irfannazril/esp8266-transceiver-robot-soccer/flowchart/Flowchart-program-receiver -white.png

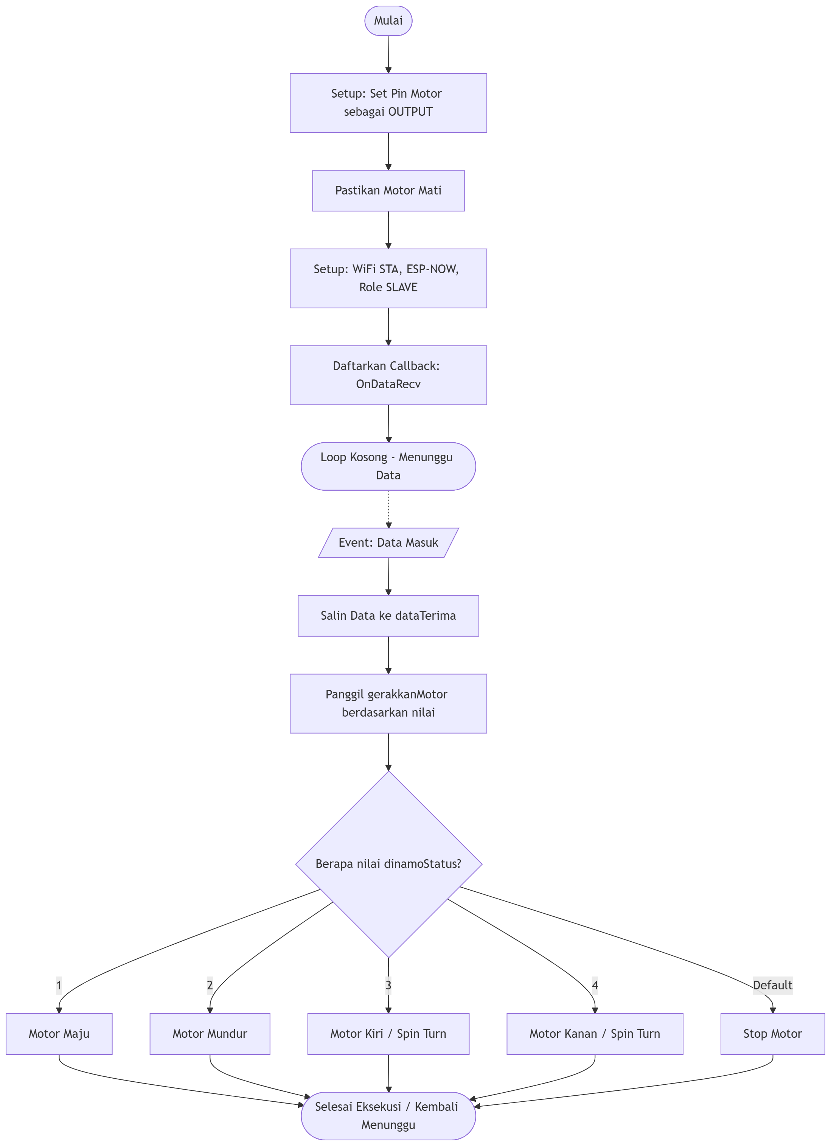
flowchart/Flowchart-program-receiver -white.png
