irfannazril/esp8266-transceiver-robot-soccer/flowchart/Flowchart-program-sender-white.png

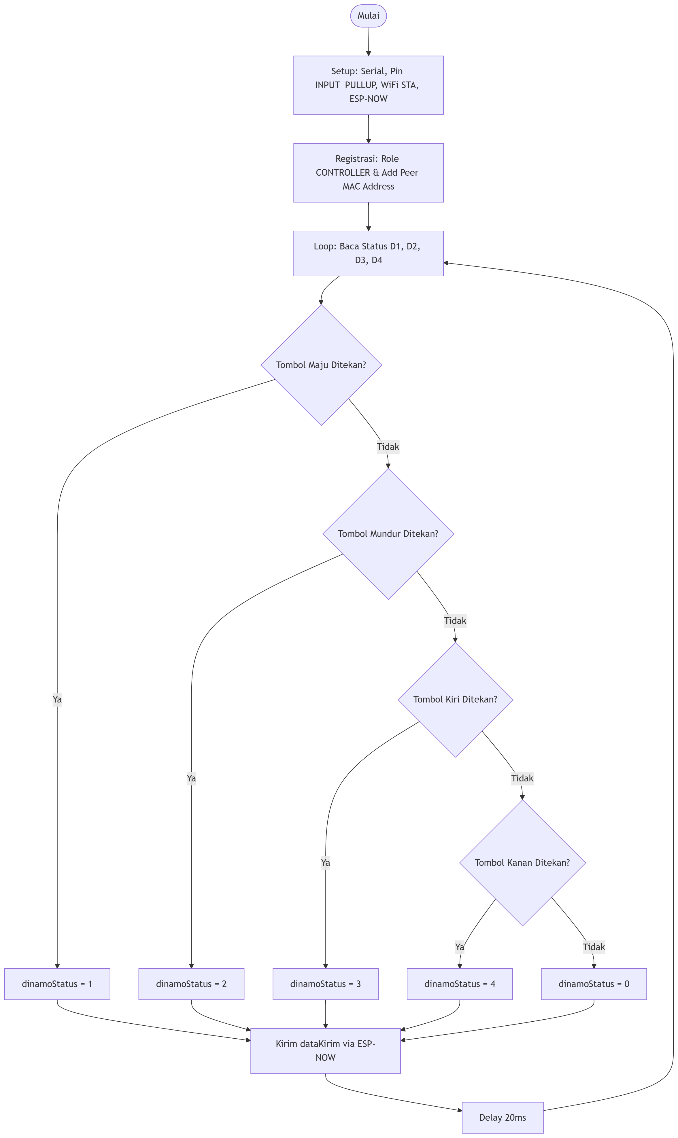
flowchart/Flowchart-program-sender-white.png
