irfannazril/esp8266-transceiver-robot-soccer/(commit log)

2026-06-25 Revise README with project details and challenges
    Updated the technical details and challenges faced during the project, including improvements in power management and component selection.
2026-06-25 Update README with additional documentation images
    Added images for PCB soldering results and robot soccer.
2026-06-25 Implement ESP-NOW receiver for motor control
    This code implements an ESP-NOW receiver for controlling motors using the DRV8833 driver based on received commands.
